jlpoltrack/SimpleCANBreakout/production/bom.csv

Designator | Footprint | Quantity | Value | LCSC Part #
C1, C4, C6 | 0603 | 3 | 10u | C19702
C2, C3, C5 | 0603 | 3 | 100n | C14663
R1 | 0603 | 1 | 120 | C22787
TP1 | TestPoint_Pad_2.5x2.5mm | 1 | CANH
TP2 | TestPoint_Pad_2.5x2.5mm | 1 | CANL
TP3, TP5 | TestPoint_Pad_2.5x2.5mm | 2 | 5
TP4, TP6 | TestPoint_Pad_2.5x2.5mm | 2 | G
TP7 | TestPoint_Pad_2.5x2.5mm | 1 | TX
TP8 | TestPoint_Pad_2.5x2.5mm | 1 | RX
U1 | SOIC-8_3.9x4.9mm_P1.27mm | 1 | SN65HVD230 | C12084
U2 | SOT-223-3_TabPin2 | 1 | AMS1117-3.3 | C6186
