jlpoltrack/SimpleCANBreakout/SimpleCANBreakout.pdf

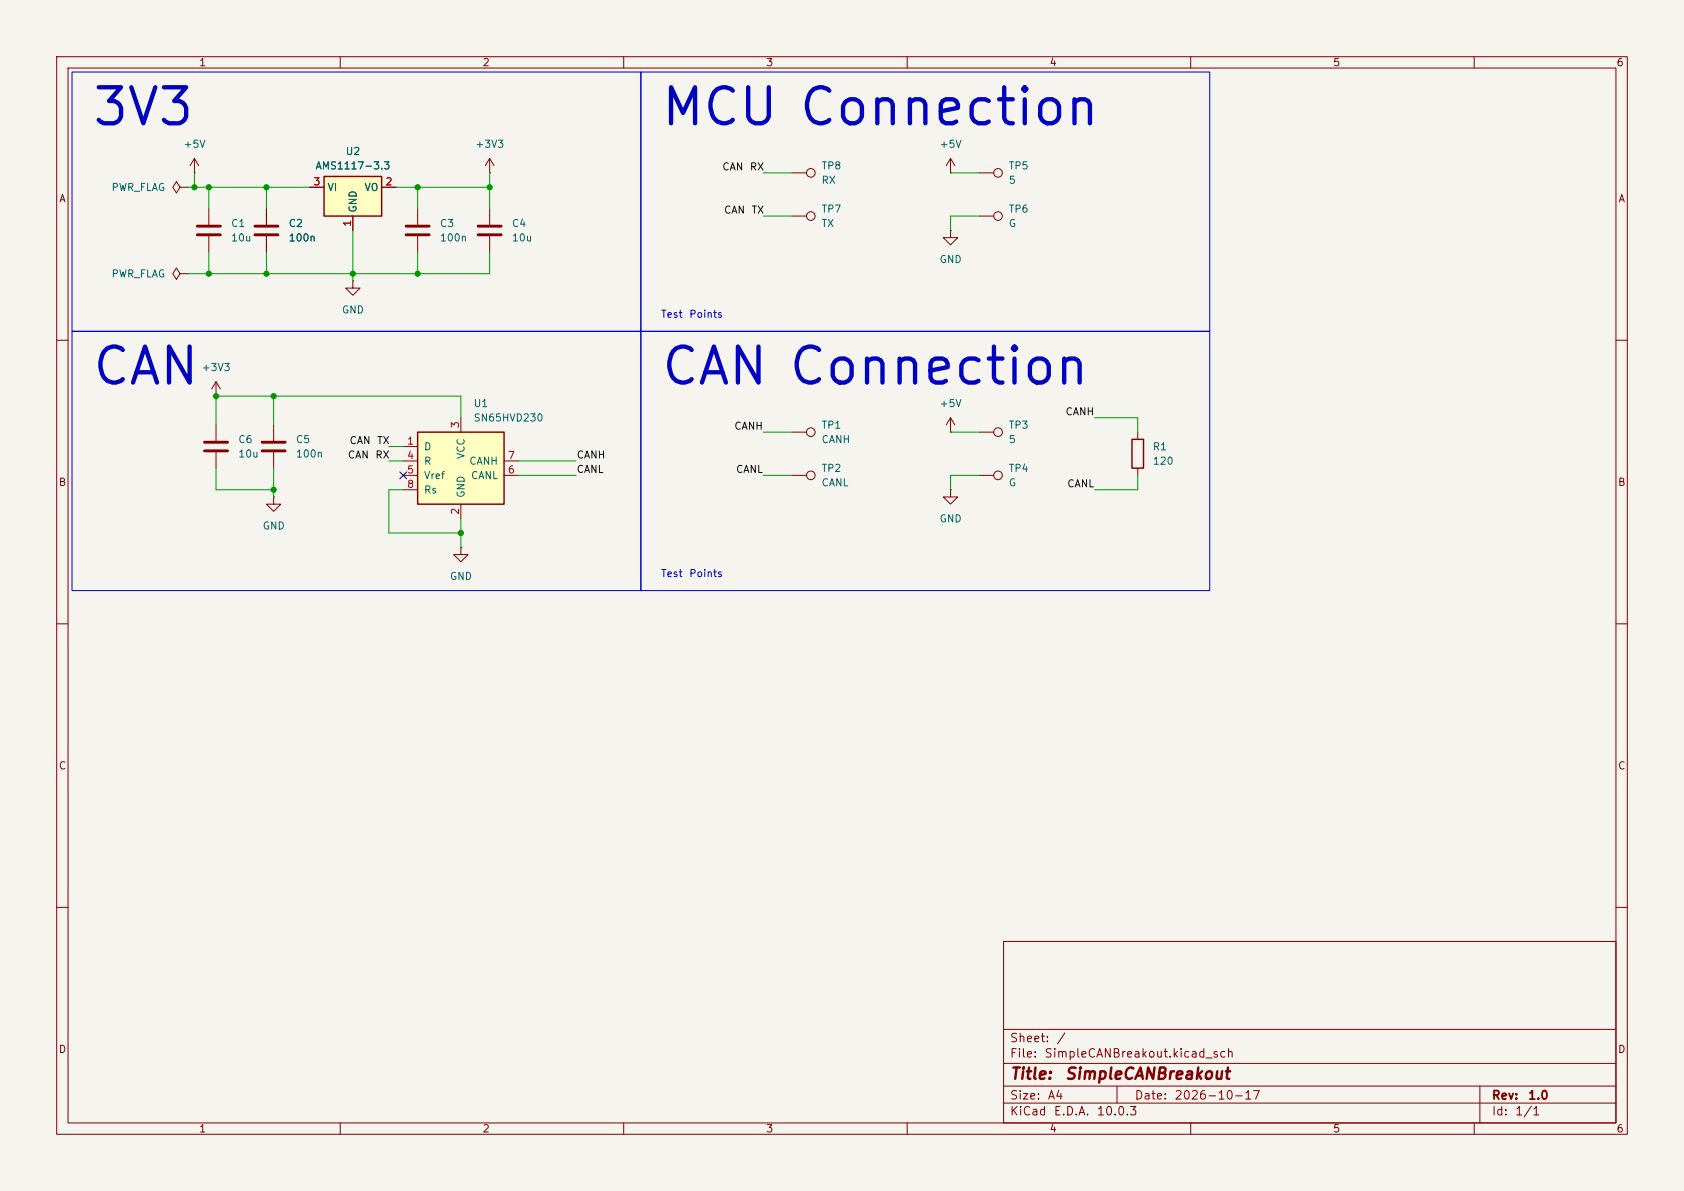
[picture p3: page 1]

Test Points MCU Connection TP7 GND

CAN | CAN Connection TP2 CANL CANL CANH GND | 120 TP4 G

Size: A4 | Rev: 1.0
KiCad E.D.A. 10.0.3 | Id: 1/1
