jlpoltrack/SimpleCANBreakout/SimpleCANBreakout.kicad_pcb

## KiCad design SimpleCANBreakout.kicad_pcb (2026-10-18)

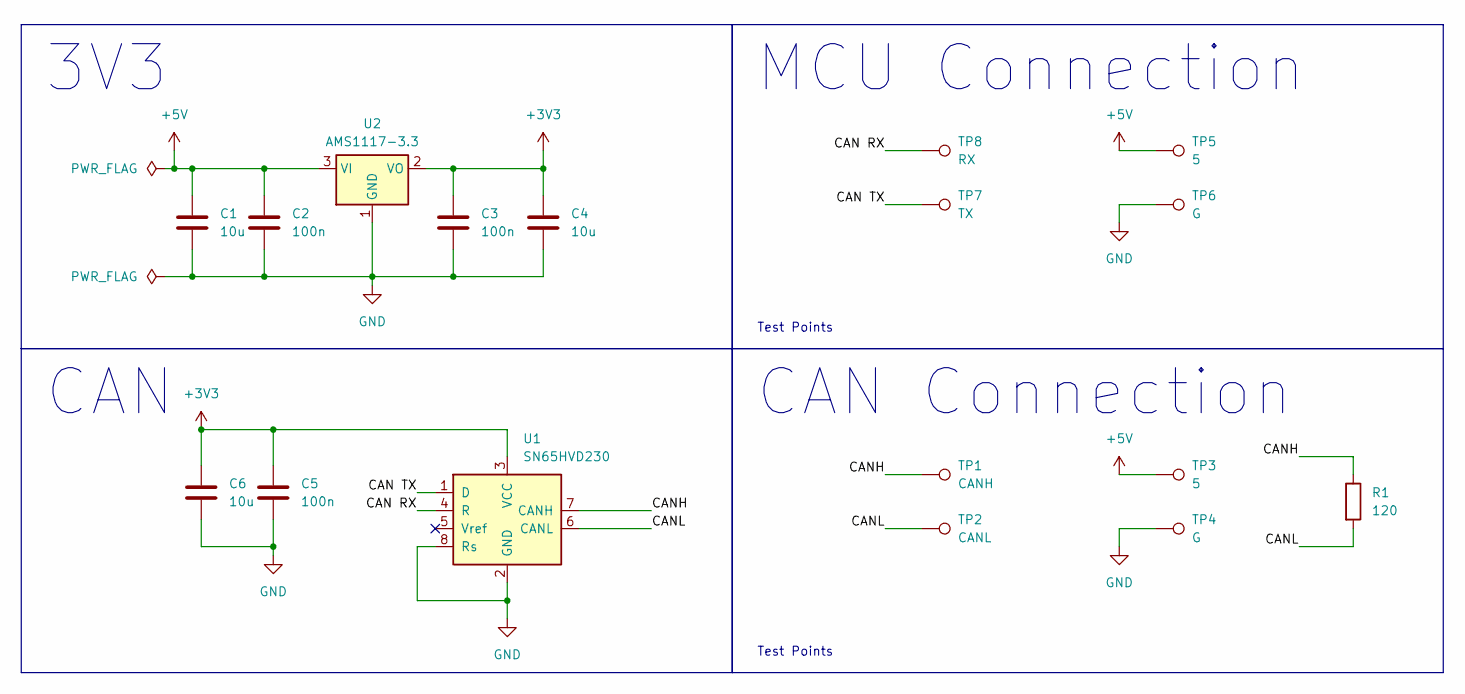
[picture p4: schematic SimpleCANBreakout.kicad_sch]

Parts:
C1, C4, C6: 10u; C_0603_1608Metric_Pad1.08x0.95mm_HandSolder; LCSC Part C19702
C2, C3, C5: 100n; C_0603_1608Metric_Pad1.08x0.95mm_HandSolder; LCSC Part C14663
R1: 120; R_0603_1608Metric_Pad0.98x0.95mm_HandSolder; LCSC Part C22787
TP1: CANH; TestPoint_Pad_2.5x2.5mm
TP2: CANL; TestPoint_Pad_2.5x2.5mm
TP3, TP5: 5; TestPoint_Pad_2.5x2.5mm
TP4, TP6: G; TestPoint_Pad_2.5x2.5mm
TP7: TX; TestPoint_Pad_2.5x2.5mm
TP8: RX; TestPoint_Pad_2.5x2.5mm
U1: SN65HVD230; SOIC-8_3.9x4.9mm_P1.27mm; LCSC Part C12084
U2: AMS1117-3.3; SOT-223-3_TabPin2; LCSC Part C6186

Connections:
+3V3: C3.1, C4.1, C5.1, C6.1, U1.3 (VCC), U2.2 (VO)
+5V: C1.1, C2.1, TP3.1 (1_1), TP5.1 (1_1), U2.3 (VI)
/CAN RX: TP8.1 (1_1), U1.4 (R)
/CAN TX: TP7.1 (1_1), U1.1 (D)
/CANH: R1.1, TP1.1 (1_1), U1.7 (CANH)
/CANL: R1.2, TP2.1 (1_1), U1.6 (CANL)
GND: C1.2, C2.2, C3.2, C4.2, C5.2, C6.2, TP4.1 (1_1), TP6.1 (1_1), U1.2 (GND), U1.8 (Rs), U2.1 (GND)

Notes on the sheet:
3V3
MCU Connection
CAN
CAN Connection
Test Points

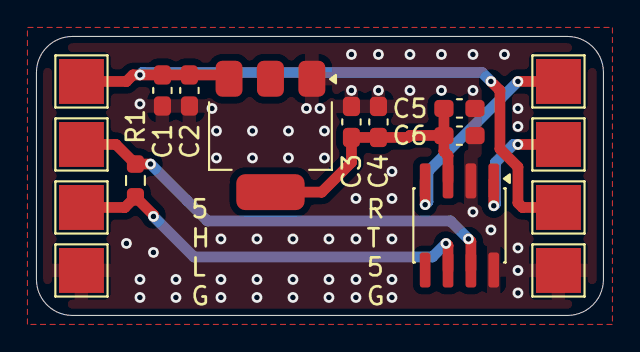
[picture p5: board SimpleCANBreakout.kicad_pcb from above]

Board: 2 copper layers, 31.5 x 15.5 mm, 17 parts (0 on the bottom side), 7 nets.
