jlpoltrack/SimpleCANBreakout/(commit log)

2026-10-17 Initial commit: KiCad project, schematic PDF, renders, production files, and README
    [SimpleCANBreakout.kicad_pcb, SimpleCANBreakout.kicad_sch, bom.csv, designators.csv, positions.csv]
2026-10-17 Swap TCAN332 for SN65HVD230 and add LCSC part numbers
    Rs (pin 8) is tied to GND through the existing pour for high-speed mode.
    Production files regenerated with the Fabrication Toolkit.
    [SimpleCANBreakout.kicad_pcb, SimpleCANBreakout.kicad_sch, bom.csv]
2026-10-18 Schematic title block (title, date, rev 1.0); PDF re-exported
    [SimpleCANBreakout.kicad_sch]
2026-10-18 Schematic: headings aligned in their boxes, CAN heading off the border (sch_tidy.py)
    [SimpleCANBreakout.kicad_sch]
2026-10-18 U2 (AMS1117 SOT-223): tab and pin 2 marked as internally joined (duplicate_pad_numbers_are_jumpers) - clears the DRC unconnected item
    [SimpleCANBreakout.kicad_pcb]
